andreabadan/STM32F103_Telemetry_V01/README.md

# STM32F103_Telemetry_V01
Board used to log data from karting training session and send them via bluetooth.  

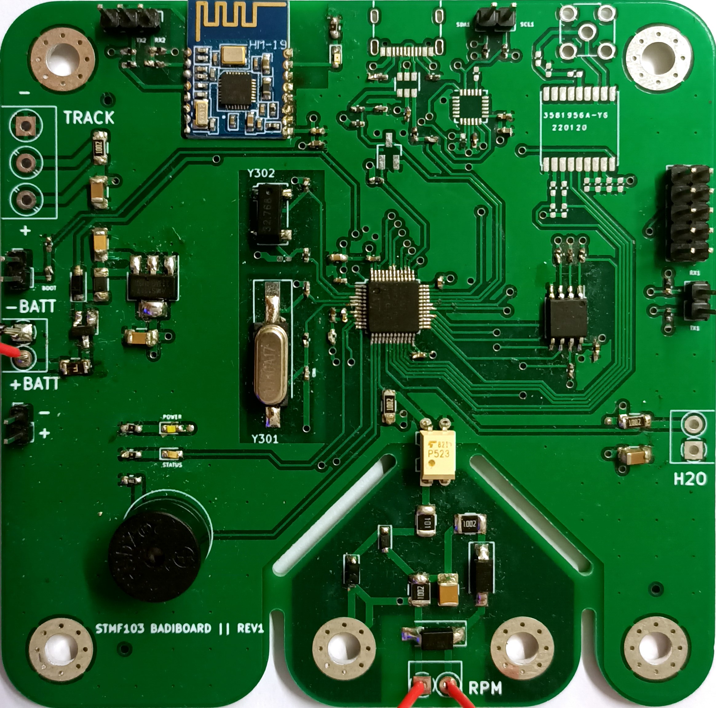
[picture p1: Board_STM32F103C8T6/Images/PCB.jpg]
