andreabadan/STM32F103_Telemetry_V01/Board_STM32F103C8T6/STM32F103C8T6/Assembly/Carrello_gen16_0939.xls

CARRELLO
Questa non è una fattura
16-gen-22 09:39:44
 | N. Mouser | N. produttore | Produttore | N. cliente | Descrizione | RoHS: | Ciclo di vita | Q.tà ordine | Prezzo (EUR) | Prezzo esteso: (EUR)
1 | 934-551403H02A | 55140-3H-02-A | Littelfuse |  | Sensori magnetici/a effetto Hall industriali MIN FLANGE MNT PROX SENS 3WIRE | A norma RoHS | NRND | 1 | 9,99 € | 9,99 €
2 | 934-55140AP02A | 55140-AP-02-A | Littelfuse |  | Sensori magnetici/a effetto Hall industriali 55140 AP02A HALL SENSOR | A norma RoHS |  | 1 | 13,58 € | 13,58 €
3 | 511-STM32F103C8T6 | STM32F103C8T6 | STMicroelectronics |  | Microcontrollori ARM - MCU 32BIT Cortex M3 64KB 20KB RAM 2X12 ADC | A norma RoHS |  | 1 | 6,13 € | 6,13 €
4 | 581-0402YD104K | 0402YD104KAT2A | Kyocera AVX |  | Condensatori in ceramica multistrato MLCC - SMD/SMT 16V 0.1uF X5R 0402 10% | A norma RoHS |  | 13 | 0,022 € | 0,29 €
5 | 581-0402YD105KAT4A | 0402YD105KAT4A | Kyocera AVX |  | Condensatori in ceramica multistrato MLCC - SMD/SMT 16V 1uF X5R 0402 10% AEC-Q200 | A norma RoHS |  | 1 | 0,333 € | 0,33 €
6 | 581-0402ZC103KAT2A | 0402ZC103KAT2A | Kyocera AVX |  | Condensatori in ceramica multistrato MLCC - SMD/SMT 10V 0.01uF X7R 0402 10% | A norma RoHS |  | 2 | 0,263 € | 0,53 €
7 | 581-1206VC104KAT2A | 1206VC104KAT2A | Kyocera AVX |  | Condensatori in ceramica multistrato MLCC - SMD/SMT 250V .1uF X7R 1206 10% Tol | A norma RoHS |  | 1 | 0,621 € | 0,62 €
8 | 581-1206DD106KAT2A | 1206DD106KAT2A | Kyocera AVX |  | Condensatori in ceramica multistrato MLCC - SMD/SMT 35V 10uF X5R 1206 10% | A norma RoHS |  | 3 | 0,613 € | 1,84 €
9 | 581-0603ZD475KAT2A | 0603ZD475KAT2A | Kyocera AVX |  | Condensatori in ceramica multistrato MLCC - SMD/SMT 10V 4.7uF X5R 0603 10% | A norma RoHS |  | 1 | 0,324 € | 0,32 €
10 | 581-0402ZA470JAT2A | 0402ZA470JAT2A | Kyocera AVX |  | Condensatori in ceramica multistrato MLCC - SMD/SMT 10V 47pF C0G 0402 5% | A norma RoHS |  | 2 | 0,28 € | 0,56 €
11 | 581-0402ZD106MAT2A | 0402ZD106MAT2A | Kyocera AVX |  | Condensatori in ceramica multistrato MLCC - SMD/SMT 10V 10uF X5R 0402 20% | A norma RoHS |  | 3 | 0,473 € | 1,42 €
12 | 581-0402YC222J4T2A | 0402YC222J4T2A | Kyocera AVX |  | Condensatori in ceramica multistrato MLCC - SMD/SMT 16V 2200pF X7R 0402 5% AEC-Q200 | A norma RoHS |  | 1 | 0,359 € | 0,36 €
13 | 581-1210VC224KAT2A | 1210VC224KAT2A | Kyocera AVX |  | Condensatori in ceramica multistrato MLCC - SMD/SMT 250V 0.22uF X7R 1210 10% | A norma RoHS | Nuovo prodotto | 1 | 0,656 € | 0,66 €
14 | 833-B5819W-TP | B5819W-TP | Micro Commercial Components (MCC) |  | Diodi e raddrizzatori Schottky 1A, 40V | A norma RoHS |  | 1 | 0,35 € | 0,35 €
15 | 710-150060GS75020 | 150060GS75020 | Wurth Elektronik |  | LED standard - SMD Mono Waterclear 670mcd 3.2V 140 | A norma RoHS |  | 1 | 0,315 € | 0,32 €
16 | 710-150060BS55040 | 150060BS55040 | Wurth Elektronik |  | LED standard - SMD WL-SMCD SMD Mono SMD 0603 Blue 465nm | A norma RoHS |  | 1 | 0,158 € | 0,16 €
17 | 710-150060RS75020 | 150060RS75020 | Wurth Elektronik |  | LED standard - SMD Mono Waterclear 80mcd 2V 140 | A norma RoHS |  | 1 | 0,315 € | 0,32 €
18 | 78-BZT52C5V1-E3-18 | BZT52C5V1-E3-18 | Vishay |  | Diodi Zener 5.1 Volt 0.5W 5% | A norma RoHS |  | 1 | 0,254 € | 0,25 €
19 | 576-1206L050YR | 1206L050YR | Littelfuse |  | Fusibili resettabili - PPTC 1206 PTC 6V 500MA | A norma RoHS |  | 1 | 0,411 € | 0,41 €
20 | 70-ILHB1206ER601V | ILHB1206ER601V | Vishay |  | Perline di ferrite 600ohms 25% | A norma RoHS |  | 1 | 0,166 € | 0,17 €
21 | 710-7447840139 | 7447840139 | Wurth Elektronik |  | Induttori fissi WE-MK 0402 39nH 200mA DCR=1.06ohm | A norma RoHS | Nuovo a Mouser | 1 | 0,088 € | 0,09 €
22 | 710-7447840210G | 7447840210G | Wurth Elektronik |  | Induttori fissi WE-MK DCRes= 1.6Ohms 0402 0.15A +/- 2% | A norma RoHS | Nuovo prodotto | 1 | 0,088 € | 0,09 €
23 | 726-BSS123NH6327 | BSS123N H6327 | Infineon |  | MOSFET N-Ch 100V 190mA SOT-23-3 | A norma RoHS |  | 1 | 0,368 € | 0,37 €
24 | 511-LD1117S33 | LD1117S33TR | STMicroelectronics |  | Regolatori di tensione LDO 3.3V 0.8A Positive | Conforme RoHS per esenzione |  | 1 | 0,525 € | 0,53 €
25 | 454-W25Q128JVSIQTR | W25Q128JVSIQ TR | Winbond |  | NOR Flash spiFlash, 3V, 128M-bit, 4Kb Uniform Sector | A norma RoHS |  | 1 | 1,74 € | 1,74 €
26 | 511-USBLC6-2SC6 | USBLC6-2SC6 | STMicroelectronics |  | Soppressori ESD/Diodi TVS ESD Protection Low Cap | A norma RoHS |  | 1 | 0,49 € | 0,49 €
27 | 581-04025U240FAT2A | 04025U240FAT2A | Kyocera AVX |  | Condensatori in ceramica multistrato MLCC - SMD/SMT 50V 24pF C0G 0402 1% | A norma RoHS |  | 2 | 0,315 € | 0,63 €
28 | 660-RN73H1ETP7870D25 | RN73H1ETTP7870D25 | KOA Speer |  | Resistori a pellicola sottile - SMD 787Ohm,0402,0.5%,25p pm,63mW,50V | A norma RoHS |  | 1 | 0,503 € | 0,50 €
29 | 581-04023U130FAT2A | 04023U130FAT2A | Kyocera AVX |  | Condensatori in ceramica multistrato MLCC - SMD/SMT 25V 13pF C0G 0402 1% | A norma RoHS |  | 2 | 0,333 € | 0,67 €
30 | 815-ABS25-32.7K-4-T | ABS25-32.768KHz-4-T | ABRACON |  | Cristalli CRYSTAL 32.7680KHZ 12.5PF SMD | Conforme RoHS per esenzione |  | 1 | 0,91 € | 0,91 €
31 | 660-RN73H1ETP3602D25 | RN73H1ETTP3602D25 | KOA Speer |  | Resistori a pellicola sottile - SMD 36kOhm,0402,0.5%,25p pm,63mW,50V | A norma RoHS |  | 1 | 0,503 € | 0,50 €
32 | 815-ABLS-8.0M-T | ABLS-8.000MHZ-B4-T | ABRACON |  | Cristalli 8.0 MHZ 18PF 80 OHM AUTO | A norma RoHS |  | 1 | 0,236 € | 0,24 €
33 | 78-SI2301CDS-T1-BE3 | SI2301CDS-T1-BE3 | Vishay |  | MOSFET P-CHANNEL 20-V (D-S) | A norma RoHS | Nuovo prodotto | 1 | 0,446 € | 0,45 €
34 | 78-SI2312BDS-T1-BE3 | SI2312BDS-T1-BE3 | Vishay |  | MOSFET N-CHANNEL 20-V (D-S) | A norma RoHS | Nuovo prodotto | 1 | 0,543 € | 0,54 €
35 | 241-1N4148WSR100001 | 1N4148WS_R1_00001 | Panjit |  | Diodi - Uso generico, alimentazione, commutazione /A2/TR/7"/HF/5K/SOD-323/SWI/SOD/USM-02A/USM02-QI08/PJ/// | A norma RoHS | Nuovo a Mouser | 1 | 0,123 € | 0,12 €
36 | 755-KTR03EZPJ152 | KTR03EZPJ152 | ROHM Semiconductor |  | Resistori a pellicola spessa - SMD 0603 1.5Kohm 5% High Voltage | Conforme RoHS per esenzione |  | 3 | 0,123 € | 0,37 €
37 | 652-CR0402FX-2201GLF | CR0402-FX-2201GLF | Bourns |  | Resistori a pellicola spessa - SMD 2.2K OHM 1% | Conforme RoHS per esenzione |  | 2 | 0,088 € | 0,18 €
38 | 652-CR0402-FX7870GLF | CR0402-FX-7870GLF | Bourns |  | Resistori a pellicola spessa - SMD 787OHM 1/16WATT 1% | Conforme RoHS per esenzione |  | 1 | 0,123 € | 0,12 €
39 | 71-CRCW0402J-36K-E3 | CRCW040236K0JNED | Vishay |  | Resistori a pellicola spessa - SMD 1/16watt 36Kohms 5% | Conforme RoHS per esenzione |  | 1 | 0,088 € | 0,09 €
40 | 71-CRCW04024K70FKEDC | CRCW04024K70FKEDC | Vishay |  | Resistori a pellicola spessa - SMD 1/16watt 4.7Kohms 1% Commercial Use | Conforme RoHS per esenzione |  | 1 | 0,088 € | 0,09 €
41 | 71-CRCW040210K0FKEDC | CRCW040210K0FKEDC | Vishay |  | Resistori a pellicola spessa - SMD 1/16watt 10Kohms 1% Commercial Use | Conforme RoHS per esenzione |  | 5 | 0,088 € | 0,44 €
42 | 652-CR0402FX-1501GLF | CR0402-FX-1501GLF | Bourns |  | Resistori a pellicola spessa - SMD 1.5K OHM 1% | Conforme RoHS per esenzione |  | 1 | 0,088 € | 0,09 €
43 | 652-CR0402FX-2202GLF | CR0402-FX-2202GLF | Bourns |  | Resistori a pellicola spessa - SMD 22K OHM 1% | Conforme RoHS per esenzione |  | 2 | 0,088 € | 0,18 €
44 | 652-CR0402FX-1001GLF | CR0402-FX-1001GLF | Bourns |  | Resistori a pellicola spessa - SMD 1.0K OHM 1% | Conforme RoHS per esenzione |  | 2 | 0,088 € | 0,18 €
45 | 652-CR0402-J/-000GLF | CR0402-J/-000GLF | Bourns |  | Resistori a pellicola spessa - SMD Zero Ohm 5% | Conforme RoHS per esenzione |  | 2 | 0,088 € | 0,18 €
46 | 652-CR0603-FX-103ELF | CR0603-FX-1003ELF | Bourns |  | Resistori a pellicola spessa - SMD 100K 1% 1/10 WATT | Conforme RoHS per esenzione |  | 1 | 0,088 € | 0,09 €
47 | 603-RC1210FR-0710KL | RC1210FR-0710KL | YAGEO |  | Resistori a pellicola spessa - SMD 10 kOhms 500 mW 1210 1% | Conforme RoHS per esenzione |  | 2 | 0,149 € | 0,30 €
48 | 652-CR1206FX-1002ELF | CR1206-FX-1002ELF | Bourns |  | Resistori a pellicola spessa - SMD 10K 1% | Conforme RoHS per esenzione |  | 3 | 0,088 € | 0,26 €
49 | 652-CR0402JW-104GLF | CR0402-JW-104GLF | Bourns |  | Resistori a pellicola spessa - SMD 100K OHM 5% | Conforme RoHS per esenzione |  | 8 | 0,088 € | 0,70 €
50 | 538-73391-0080 | 73391-0080 | Molex |  | Connettori RF/Connettori coassiali RA JACK PCB | Conforme RoHS per esenzione |  | 1 | 3,37 € | 3,37 €
51 | 640-USB4105-GF-A | USB4105-GF-A | Global Connector Technology (GCT) |  | Connettori USB USB Type C,2.0, Rec,SMT,TH Shell Stakes,G/F,RA,Top Mnt,T&R | A norma RoHS | Nuovo prodotto | 1 | 0,709 € | 0,71 €
52 | 621-S1B-F | S1B-13-F | Diodes Incorporated |  | Raddrizzatori 100V 1A | Conforme RoHS per esenzione |  | 2 | 0,236 € | 0,47 €
53 | 652-CR0402-JW-512GLF | CR0402-JW-512GLF | Bourns |  | Resistori a pellicola spessa - SMD 5.1KOHM 1/16WATT 5% | Conforme RoHS per esenzione |  | 2 | 0,088 € | 0,18 €
54 | 660-RK73B2ETTD101J | RK73B2ETTD101J | KOA Speer |  | Resistori a pellicola spessa - SMD 1/2watts 100ohms 5% | Conforme RoHS per esenzione |  | 1 | 0,161 € | 0,16 €
Inviando l'ordine si accettano queste termini e condizioni. (https://www.mouser.it/saleterms) |  |  |  |  |  |  |  |  | Merce: | 54,64 €
I prezzi riflettono quelli validi alla data e all'ora mostrate. |  |  |  |  |  |  |  |  | Spese di spedizione: | 0,00 €
 |  |  |  |  |  |  |  |  | Spedizione ordini arretrati: | 0,00 €
