andreabadan/STM32F103_Telemetry_V01/Board_STM32F103C8T6/Case/FrontPanel.stl

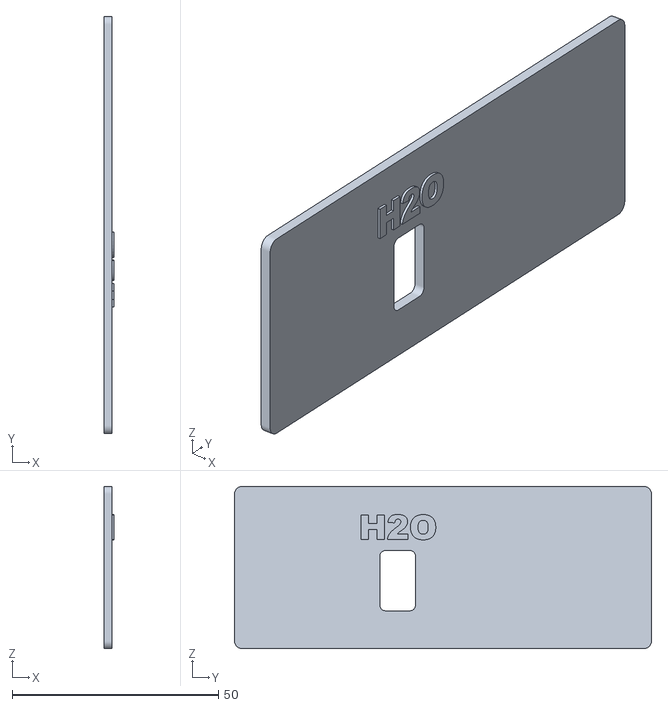
[picture p2: CAD file, 2022-06-16]
Board_STM32F103C8T6/Case/FrontPanel.stl
2.50 x 101.2 x 39.4
