andreabadan/STM32F103_Telemetry_V01/Board_STM32F103C8T6/Case/Top.stl

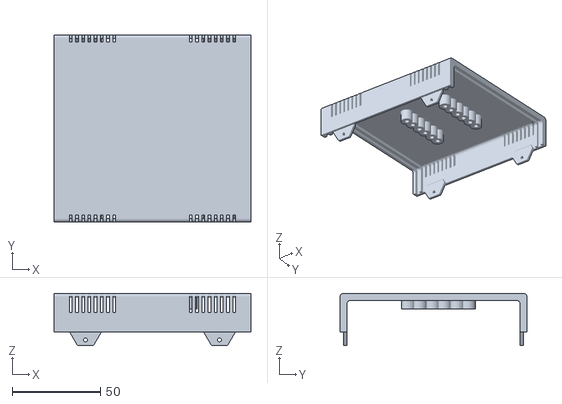
[picture p4: CAD file, 2022-06-16]
Board_STM32F103C8T6/Case/Top.stl
111.6 x 106.0 x 29.6
