andreabadan/STM32F103_Telemetry_V01/Board_STM32F103C8T6/Case/Battery.stl

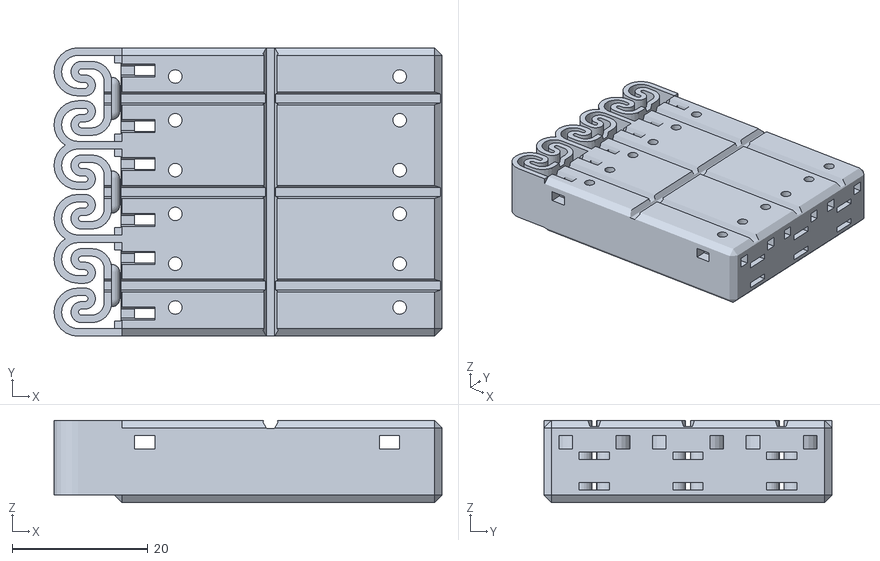
[picture p5: CAD file, 2022-06-16]
Board_STM32F103C8T6/Case/Battery.stl
57.2 x 42.5 x 12.1
