andreabadan/STM32F103_Telemetry_V01/Board_STM32F103C8T6/Simulation/RPM_probe_simulation.asc

C1: cap; 0.1µ; V=16 Irms=3.85 Rser=0.0464862 Lser=0
D1: diode; 1N4007
D2: diode; 1N4007
D3: diode; 1N4148
D5: zener; 1N751
R1: res; 4.75K; tol=1 pwr=0.1
R2: res; 10K; tol=1 pwr=0.1
R3: res; 100; tol=1 pwr=0.1
R4: res; 20K; tol=1 pwr=0.1
U1: PC817A
V1: voltage; PULSE(0 5 0 0.01m 0.01m 1m 10m); Rser=0
V2: voltage; 3.3; Rser=0
Named nets: 0
.tran 40m
