andreabadan/STM32F103_Telemetry_V01/Board_STM32F103C8T6/STM32F103C8T6/STM32F103C8T6.kicad_pcb

## KiCad design Board_STM32F103C8T6/STM32F103C8T6/STM32F103C8T6.kicad_pcb (2022-05-08)

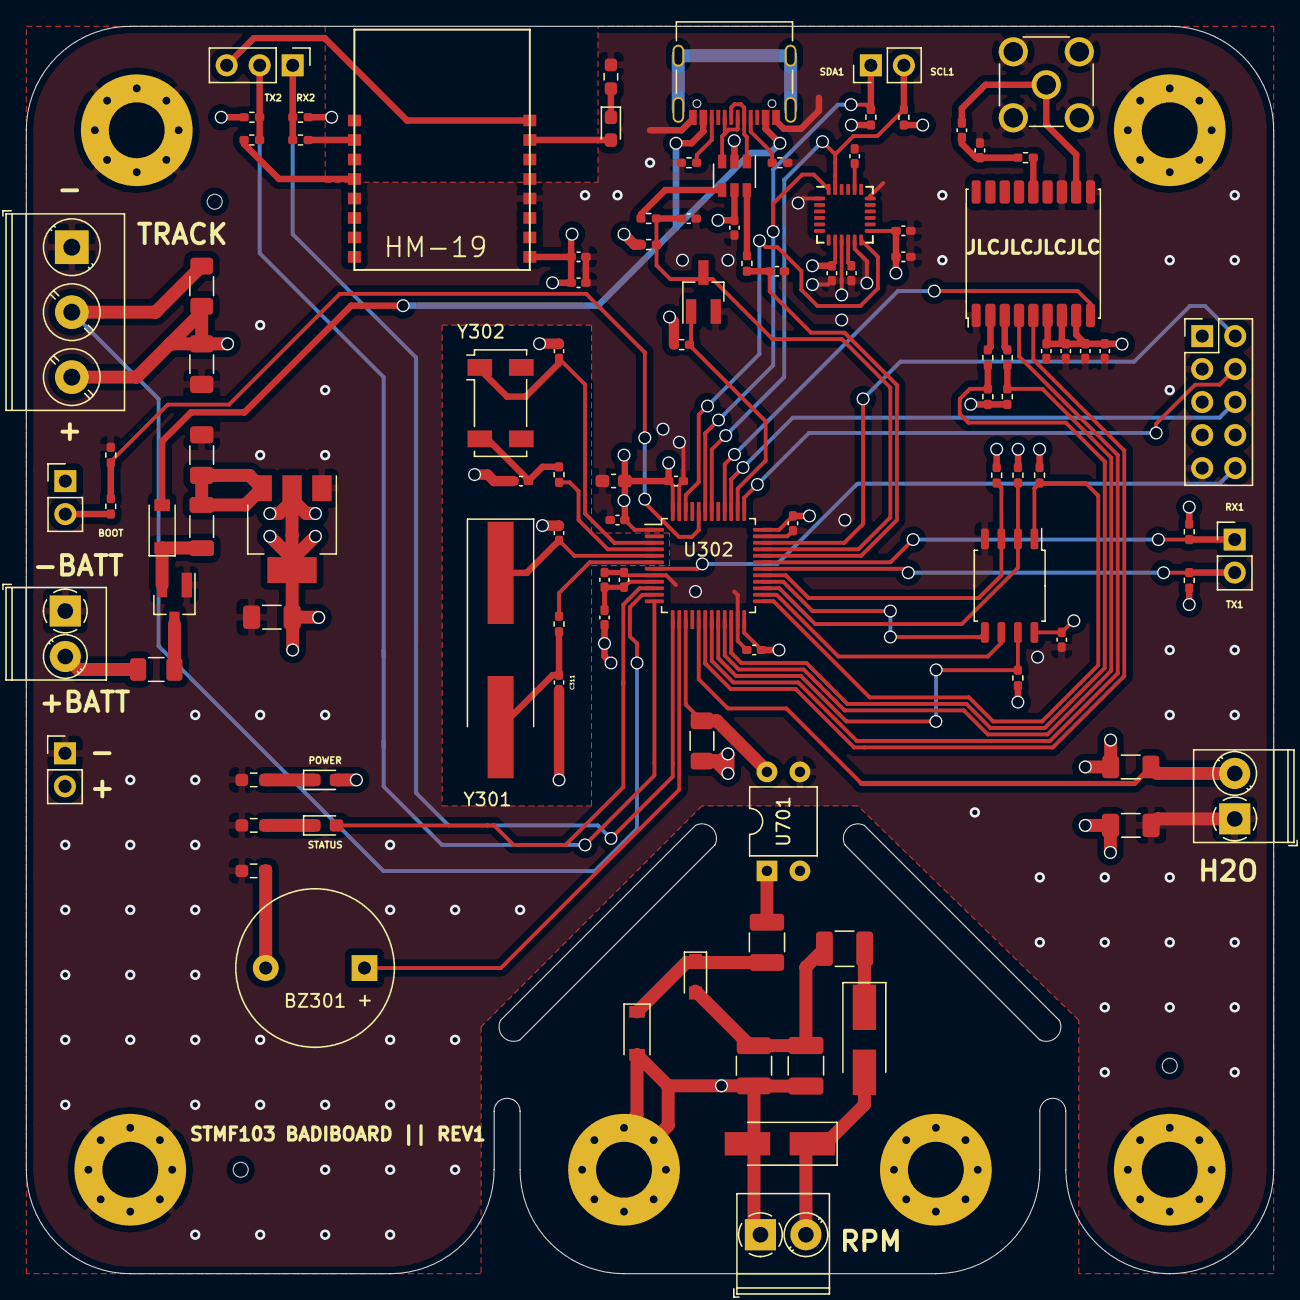
[picture p15: board STM32F103C8T6.kicad_pcb from above]

Board: 4 copper layers, 96.0 x 96.0 mm, 115 parts (0 on the bottom side), 73 nets.

Parts:
BZ301: Buzzer; Buzzer_12x9.5RM7.6
C201: 0.1uF; C_1206_3216Metric_Pad1.33x1.80mm_HandSolder
C202, C701, C703: 10uF; C_1206_3216Metric_Pad1.33x1.80mm_HandSolder
C301: 4.7uF; C_0603_1608Metric_Pad1.08x0.95mm_HandSolder
C302, C303, C304, C305, C308, C401, C502, C503, C504, C602, C802, C803, C804: 0.1uF; C_0402_1005Metric_Pad0.74x0.62mm_HandSolder
C306: 1uF; C_0402_1005Metric_Pad0.74x0.62mm_HandSolder
C307, C805: 0.01uF; C_0402_1005Metric_Pad0.74x0.62mm_HandSolder
C309, C311: 24pF; C_0402_1005Metric_Pad0.74x0.62mm_HandSolder
C310, C312: 13pF; C_0402_1005Metric_Pad0.74x0.62mm_HandSolder
C402, C403: 47pF; C_0402_1005Metric_Pad0.74x0.62mm_HandSolder
C501, C601, C801: 10uF; C_0402_1005Metric_Pad0.74x0.62mm_HandSolder
C505: 2200pF; C_0402_1005Metric_Pad0.74x0.62mm_HandSolder
C702: 0.1uF; C_1210_3225Metric_Pad1.33x2.70mm_HandSolder
D201: B5819W; D_SOD-123
D202: GREEN; LED_0603_1608Metric_Pad1.05x0.95mm_HandSolder
D301: BLUE; LED_0603_1608Metric_Pad1.05x0.95mm_HandSolder
D601: RED; LED_0603_1608Metric_Pad1.05x0.95mm_HandSolder
D701, D702: 1N4007F; D_SMA_Handsoldering
D703: 1N4148WS; D_SOD-323_HandSoldering
D704: 5v1; D_SOD-123
F201: 500mA; Fuse_1206_3216Metric
FB201: 600 @ 600 MHz; L_1206_3216Metric_Pad1.22x1.90mm_HandSolder
H301, H302, H303, H304, H305, H306: MountingHole_Pad; MountingHole_4.3mm_M4_Pad_Via
H307, H308, H309: MountingHole; JLCPCB-Tooling-Hole
J301: BOOT; PinHeader_1x02_P2.54mm_Vertical
J401: BATTERY; TerminalBlock_Phoenix_PT-1,5-2-3.5-H_1x02_P3.50mm_Horizontal
J402: I2C; PinHeader_1x02_P2.54mm_Vertical
J403: H2O; TerminalBlock_Phoenix_PT-1,5-2-3.5-H_1x02_P3.50mm_Horizontal
J404: USB_C_Receptacle_USB2.0; USB_C_Receptacle_Palconn_UTC16-G
J405: SWD; PinHeader_2x05_P2.54mm_Vertical
J406: USART1; PinHeader_1x02_P2.54mm_Vertical
J407: CIRCUIT_SENSOR; TerminalBlock_Phoenix_PT-1,5-3-5.0-H_1x03_P5.00mm_Horizontal
J408: BLUETOOTH; PinHeader_1x03_P2.54mm_Vertical
J409: RPM; TerminalBlock_Phoenix_PT-1,5-2-3.5-H_1x02_P3.50mm_Horizontal
J410: POWER; PinHeader_1x02_P2.54mm_Vertical
J801: Conn_Coaxial; SMA_Molex_73251-2200_Horizontal
L301: 39nH; L_0402_1005Metric_Pad0.77x0.64mm_HandSolder
L801: 100nH; L_0402_1005Metric_Pad0.77x0.64mm_HandSolder
Q201: SI2301CDS-T1-BE3; SOT-23_Handsoldering
Q301: SI2312BDS-T1-BE3; SOT-23_Handsoldering
R201, R311, R603: 1.5kΩ; R_0603_1608Metric_Pad0.98x0.95mm_HandSolder
R301, R302: 2.2kΩ; R_0402_1005Metric_Pad0.72x0.64mm_HandSolder
R303, R304, R306, R308, R309, R310, R313, R314: 100kΩ; R_0402_1005Metric_Pad0.72x0.64mm_HandSolder
R305: 787Ω; R_0402_1005Metric_Pad0.72x0.64mm_HandSolder
R307: 36kΩ; R_0402_1005Metric_Pad0.72x0.64mm_HandSolder
R312: 100kΩ; R_0603_1608Metric_Pad0.98x0.95mm_HandSolder
R315, R316, R318, R320, R803: 10kΩ; R_0402_1005Metric_Pad0.72x0.64mm_HandSolder
R317: 4.7kΩ; R_0402_1005Metric_Pad0.72x0.64mm_HandSolder
R319: 1.5kΩ; R_0402_1005Metric_Pad0.72x0.64mm_HandSolder
R401, R402: 22kΩ; R_0402_1005Metric_Pad0.72x0.64mm_HandSolder
R403, R404: 5.1kΩ; R_0402_1005Metric_Pad0.72x0.64mm_HandSolder
R601, R602: 1kΩ; R_0402_1005Metric_Pad0.72x0.64mm_HandSolder
R701, R702, R706: 10kΩ; R_1206_3216Metric_Pad1.30x1.75mm_HandSolder
R703, R704: 10kΩ; R_1210_3225Metric_Pad1.30x2.65mm_HandSolder
R705: 100Ω; R_1210_3225Metric_Pad1.30x2.65mm_HandSolder
R801, R802: 0kΩ; R_0402_1005Metric_Pad0.72x0.64mm_HandSolder
U201: LD1117S33TR; SOT-223-3_TabPin2
U301: W25Q128JVS; SOIC-8_5.23x5.23mm_P1.27mm
U302: STM32F103C8T6; LQFP-48_7x7mm_P0.5mm
U401: USBLC6-2SC6; SOT-23-6
U501: MPU-6050; InvenSense_QFN-24_4x4mm_P0.5mm
U601: HM-19; HM-11_Module
U701: TLP627; DIP-4_W7.62mm
U801: MAX-M8Q; ublox_MAX
Y301: 8MHz; Crystal_SMD_HC49-SD_HandSoldering
Y302: 32.768KHz; Crystal_SMD_Abracon_ABS25-4Pin_8.0x3.8mm

Connections:
12C1_SDA: J402.1, R301.1, U302.43, U501.24
!HOLD_FLASH: R315.1, U301.7, U302.20
!WP_FLASH: R316.1, U301.3, U302.29
+3.3VA: C306.1, C307.1, L301.2, U302.9
+3V3: C202.1, C301.1, C302.1, C303.1, C304.1, C305.1, C308.1, C401.1, C501.1, C502.1, C503.1, C601.1, C602.1, C701.1, C703.1, C801.1, C802.1, C803.1, C804.1, D202.2, J301.1, J405.1, J407.3, J410.2, L301.1, R301.2, R302.2, R303.2, R304.2, R306.2, R308.2, R309.2, R310.2, R313.2, R314.2, R315.2, R316.2, R319.2, R320.1, R701.1, R702.1, R706.1, U201.2, U301.8, U302.1, U302.24, U302.36, U302.48, U401.5, U501.8, U501.13, U601.9, U801.6, U801.7, U801.8
+5V: D201.2, J404.A4, J404.A9, J404.B4, J404.B9
+BATT: F201.2, J401.2
BLUETOOTH_RESET: J408.3, U601.16
BOOT0: R317.1, R318.2, U302.44
BUZZER_STATUS: BZ301.1, U302.14
COIL_RPM: D701.1, D702.2, J409.2
GND: C201.2, C202.2, C301.2, C302.2, C303.2, C304.2, C305.2, C306.2, C307.2, C308.2, C309.2, C310.2, C311.2, C312.2, C401.2, C402.2, C403.2, C501.2, C502.2, C503.2, C504.2, C505.2, C601.2, C602.2, C701.2, C703.2, C801.2, C802.2, C803.2, C804.2, C805.2, H301.1, H302.1, H303.1, H304.1, J401.1, J403.1, J404.A1, J404.A12, J404.B1, J404.B12, J405.3, J405.5, J405.9, J407.1, J410.1, J801.2, Q201.1, Q301.2, R201.2, R311.1, R312.1, R318.1, R403.1, R404.1, R603.1, U201.1, U301.4, U302.8, U302.23, U302.35, U302.47, U401.2, U501.1, U501.9, U501.11, U501.18, U601.12, U701.3, U801.1, U801.10, U801.12
GND1: C702.2, D701.2, D704.2, H305.1, H306.1, J409.1, R704.2, U701.2
GPS_NRST: U302.40, U801.9
GPS_ONOFF: U302.18, U801.5
GPS_PPS: U302.19, U801.4
H2O_NTC+: J403.2, R702.2, U302.17
HSE_IN: C309.1, U302.5, Y301.1
HSE_OUT: R305.2, U302.6
I2C1_SCL: J402.2, R302.1, U302.42, U501.23
IMU_INTERRUPT: U302.46, U501.12
LED_STATUS: D301.2, U302.10
LSE_IN: C310.1, U302.3, Y302.1
LSE_OUT: R307.2, U302.4
NRST: J405.10, U302.7
unnamed: BZ301.2, R312.2
unnamed: C201.1, FB201.1, U201.3
unnamed: C311.1, R305.1, Y301.2
unnamed: C312.1, R307.1, Y302.2
unnamed: C504.1, U501.10
unnamed: C505.1, U501.20
unnamed: C702.1, D703.2, R703.1, R704.1
unnamed: C805.1, L801.1, R803.1
unnamed: D201.1, FB201.2, Q201.2
unnamed: D202.1, R201.1
unnamed: D301.1, R311.2
unnamed: D601.1, R603.2
unnamed: D601.2, U601.15
unnamed: D702.1, R703.2
unnamed: D703.1, D704.1, R705.2
unnamed: F201.1, Q201.3
unnamed: J301.2, R317.2
unnamed: J404.A5, R404.2
unnamed: J404.B5, R403.2
unnamed: J801.1, L801.2, U801.11
unnamed: R401.1, U401.6
unnamed: R402.2, U401.4
unnamed: R601.2, U601.2
unnamed: R602.2, U601.4
unnamed: R705.1, U701.1
unnamed: R801.2, U801.2
unnamed: R802.2, U801.3
unnamed: R803.2, U801.14
RPM_SENSOR: R706.2, U302.15, U701.4
SPI2_MISO: R313.1, U301.2, U302.27
SPI2_MOSI: U301.5, U302.28
SPI2_NSS_FLASH: R314.1, U301.1, U302.25
SPI2_SCK: U301.6, U302.26
SWCLK: J405.4, U302.37
SWDIO: J405.2, U302.34
SWO: J405.6, U302.39
TRACK_SENSOR: J407.2, R701.2, U302.11
USART1_RX: J406.1, R303.1, U302.31
USART1_TX: J406.2, R304.1, U302.30
USART2_RX: J408.1, R306.1, R601.1, U302.13
USART2_TX: J408.2, R308.1, R602.1, U302.12
USART3_RX: R310.1, R801.1, U302.22
USART3_TX: R309.1, R802.1, U302.21
USB_CONN_D+: J404.A6, J404.B6, U401.3
USB_CONN_D-: J404.A7, J404.B7, U401.1
USB_D+: C403.1, Q301.3, R319.1, R402.1, U302.33
USB_D-: C402.1, R401.2, U302.32
USB_EN: Q301.1, R320.2, U302.38
