andreabadan/STM32F103_Telemetry_V01/BadiApp_STM32F103CBT6/Core/Src/main.c

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
/* Includes ------------------------------------------------------------------*/
#include "main.h"
#include "usb_device.h"

/* USER CODE BEGIN Includes */
#include "usbd_cdc_if.h"

#include "BootLoaderMng.h"

#include "MemoryMng.h"

#include "BluetoothMng.h"

#include "RPM_Counter.h"
#include "Lap_Timer.h"
#include "Temperature_Sensor.h"
/* USER CODE END Includes */

ADC_HandleTypeDef hadc1;
DMA_HandleTypeDef hdma_adc1;

I2C_HandleTypeDef hi2c1;

RTC_HandleTypeDef hrtc;

SPI_HandleTypeDef hspi2;
DMA_HandleTypeDef hdma_spi2_tx;
DMA_HandleTypeDef hdma_spi2_rx;

UART_HandleTypeDef huart1;
UART_HandleTypeDef huart2;
UART_HandleTypeDef huart3;
DMA_HandleTypeDef hdma_usart2_tx;
DMA_HandleTypeDef hdma_usart2_rx;

void SystemClock_Config(void);
static void MX_GPIO_Init(void);
static void MX_DMA_Init(void);
static void MX_ADC1_Init(void);
static void MX_I2C1_Init(void);
static void MX_RTC_Init(void);
static void MX_SPI2_Init(void);
static void MX_USART1_UART_Init(void);
static void MX_USART2_UART_Init(void);
static void MX_USART3_UART_Init(void);
/**
  * @brief  The application entry point.
  * @retval int
  */
int main(void)
{
  /* MCU Configuration--------------------------------------------------------*/

  /* Reset of all peripherals, Initializes the Flash interface and the Systick. */
  HAL_Init();

  /* Configure the system clock */
  SystemClock_Config();

  /* Initialize all configured peripherals */
  MX_GPIO_Init();
  MX_DMA_Init();
  MX_ADC1_Init();
  MX_I2C1_Init();
  MX_RTC_Init();
  MX_SPI2_Init();
  MX_USART1_UART_Init();
  MX_USART2_UART_Init();
  MX_USART3_UART_Init();
  MX_USB_DEVICE_Init();
  /* USER CODE BEGIN 2 */
  // Calibrate The ADC On Power-Up For Better Accuracy
  HAL_ADCEx_Calibration_Start(&hadc1);
  //Initialization of "micros" counter
  CoreDebug->DEMCR |= CoreDebug_DEMCR_TRCENA_Msk;
  DWT->CTRL |= DWT_CTRL_CYCCNTENA_Msk;

  /*************/
  /*Init Funct**/
  /*************/
  //Initialization of "BootLoader"
  initBootLoaderMode();
  //Initialization of "NOR memory"
  initMemory(&hspi2);
  //Initialization of "Bluetooth"
  initBluetoothCommunication(&huart2);
  //Initialization of "RPM counter"
  initCounterRPM();
  //Initialization of "Track counter"
  initCounterLap();
  //Initialization of "Read temperature"
  initReadTemperature();

  /*************/
  /*****USB*****/
  /*************/
  char txtBufUSB[BUFFER_USB_LENGTH];
  uint16_t sizeBuffUSB = 0;

#ifdef DebugRPM
  uint8_t RPMdelay = 60; //From 5 to 60
  uint8_t RPMincreasing = 1; //From 0 to 1
#endif
  /* USER CODE END 2 */

  /* Infinite loop */
  /* USER CODE BEGIN WHILE */
  while (1)
  {
    /* USER CODE END WHILE */

    /* USER CODE BEGIN 3 */
	  uint32_t currentMillis = HAL_GetTick();
	  uint8_t logUpdated = 0;
	  //Write log data
	  if(currentMillis-previousMillis_LogUpdate > DELAY_LOG_UPDATE_TIME) {
		  calculateRPM();
		  //LOG
		  if(engineStatus == TurnedOn) {
			  //Session started
			  updateLog( "%u" SESSION, 111, 0); //4 Characters
		  }
		  if(engineStatus != Off) {
			  //RPM value
			  updateLog( "%u" RPM_SYMBOL, RPM_Value, 0); //6 Characters
			  if(engineStatus == TurnedOff) {
				  //Session finished
				  updateLog( "%u" SESSION, 111, 1); //4 Characters
			  }
		  }
		  //Update counter
		  previousMillis_LogUpdate = currentMillis;
		  logUpdated = 1;
	  }
	  //RPM update
	  if(currentMillis-previousMillisRPM_Display > CALCULATE_RPM_DELTA_TIME){
		  if(!logUpdated) {
			  calculateRPM();
		  }
		  //USB
		  sizeBuffUSB += sprintf(txtBufUSB, "RPM_Value: %u ", RPM_Value);
		  //BT
		  appendBTData( "%u" RPM_SYMBOL, RPM_Value); //6 Characters
		  //Update counter
		  previousMillisRPM_Display = currentMillis;
	  }
	  //Time update
	  if(currentMillis > previousMillisLap_Display && currentMillis-previousMillisLap_Display > CALCULATE_LAP_DELTA_TIME && !LapUpdateDisplay){
		  //USB
		  sizeBuffUSB += sprintf(txtBufUSB + sizeBuffUSB, "Lap value: %lu ", currentMillis-previousMillisLap);
		  //BT
		  appendBTData("%lu" LAP_SYMBOL, currentMillis-previousMillisLap); //11 Characters
		  //Update counter
		  previousMillisLap_Display = currentMillis;
	  }
	  //Track update
	  if(LapUpdateDisplay){
		  //USB
		  sizeBuffUSB += sprintf(txtBufUSB + sizeBuffUSB, "!--! Lap value: %lu !--! ", Lap_Value);
		  //BT
		  appendBTData(LAPFINISHED_SYMBOL "%lu" LAP_SYMBOL, Lap_Value); //12 Characters
		  //LOG
		  updateLog(LAPFINISHED_SYMBOL "%lu" LAP_SYMBOL, Lap_Value, 0); //12 Characters
		  //Update counter
		  previousMillisLap_Display = currentMillis + DELAY_DISPLAY_LAP_TIME;
		  LapUpdateDisplay = 0;
	  }
	  //Temperature sensor
	  if(currentMillis-previousMillisTemperature_Display > DELAY_DISPLAY_TEMPERATUIRE_SENSOR_TIME){
		  //Calculate temperature
		  if(calculateTemperature() || bluetoothStatus == Connecting){
			  //USB
			  sizeBuffUSB += sprintf(txtBufUSB + sizeBuffUSB, "Temp: %u ", TemperatureValue);
			  //BT
			  switch(TemperatureAlarmUpdateDisplay){
				  case ProbeOk:
				  case ProbeInit:
					  //BT
					  appendBTData("%u" TEMP_SYMBOL, TemperatureValue); //6 Characters
					  //LOG
					  updateLog("%u" TEMP_SYMBOL, TemperatureValue, 0); //6 Characters
					  break;
				  case HighTemperature:
					  //BT
					  appendBTData(HIGHTEMP_SYMBOL "%u" TEMP_SYMBOL, TemperatureValue); //7 Characters
					  //LOG
					  updateLog(HIGHTEMP_SYMBOL "%u" TEMP_SYMBOL, TemperatureValue, 0); //7 Characters
					  break;
				  case ProbeNotConnected:
				  case ProbeErrorReading:
					  //BT
					  appendBTData(PROBEBROKE_SYMBOL "%u" TEMP_SYMBOL, 0); //3 Characters
					  //LOG
					  updateLog(PROBEBROKE_SYMBOL "%u" TEMP_SYMBOL, 0, 0); //3 Characters
					  break;
			  }
		  }
		  //Update counter
		  previousMillisTemperature_Display = currentMillis;
	  }
	  //Read temperature value
	  if(currentMillis-previousMillisTemperature_Read > CALCULATE_TEMPERATUIRE_SENSOR_TIME){
		  HAL_ADC_Start_DMA(&hadc1, &ActualRead, 1);
		  //Update counter
		  previousMillisTemperature_Read = currentMillis;
	  }

#ifdef debugBT
	  sizeBuffUSB = sizeBuffBT;
	  for(int i=0; i<sizeBuffBT; i++)
		  txtBufUSB[i] = txtBufBT[i];
#endif
	  //Print via USB all informations
	  if(sizeBuffUSB > 0){
		  sizeBuffUSB += sprintf(txtBufUSB + sizeBuffUSB, "\r\n");
		  memset(txtBufUSB + sizeBuffUSB, 0, BUFFER_USB_LENGTH - sizeBuffUSB); //Deleate value into unused buffer
		  CDC_Transmit_FS((uint8_t *)txtBufUSB, sizeBuffUSB);
		  sizeBuffUSB   = 0;
	  }
	  //Print via BT all informations
	  writeBTData(&huart2);
	  //Led status
	  HAL_GPIO_TogglePin (Led_status_GPIO_Port, Led_status_Pin);
#ifdef DebugRPM
	  if(RPMincreasing){
	  //RPM increase = delay decrease
		  if(RPMdelay <= 5)
			  RPMincreasing = 0;
		  else
			  RPMdelay = RPMdelay - 1;
	  } else {
	  //RPM decrease = delay increase
		  if(RPMdelay >= 60)
			  RPMincreasing = 1;
		  else
			  RPMdelay = RPMdelay + 1;
	  }

	  for(int i = 0; i < CALCULATE_RPM_DELTA_TIME; i=i+RPMdelay){
		  deltaTimeInterruptRPM(DWT->CYCCNT / (SystemCoreClock / 1000000U));
		  HAL_Delay(RPMdelay-1);
	  }
#else
	  HAL_Delay(25);
#endif
  }
  /* USER CODE END 3 */
}

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
/* USER CODE BEGIN 4 */
// EXTI Line9 External Interrupt ISR Handler CallBackFun
void HAL_GPIO_EXTI_Callback(uint16_t GPIO_Pin)
{
    if(GPIO_Pin == Track_Sensor_Pin) // If The INT Source Is EXTI Line1 (Track_Sensor)
	{
    	deltaTimeInterruptLap(HAL_GetTick());
	}
    if(GPIO_Pin == RPM_Sensor_Pin) // If The INT Source Is EXTI Line5 (RPM_Sensor)
    {
    	deltaTimeInterruptRPM(DWT->CYCCNT / (SystemCoreClock / 1000000U));
    }
}
// ADC callback (temperature sensor)
void HAL_ADC_ConvCpltCallback(ADC_HandleTypeDef* hadc)
{
    // Conversion complete & DMA transfer complete as well
	averageRead();
}
// DMA USART Callback
void HAL_UARTEx_RxEventCallback(UART_HandleTypeDef *huart, uint16_t Size)
{
	switch(readBTData(huart, Size)){
		case LoadNewApp:
			jumpToBootLoader(FlashModeBT);
			break;
		default: break;
	}

}
// DMA SPI Callback
void HAL_SPI_TxRxCpltCallback(SPI_HandleTypeDef * hspi)
{
    if(hspi->Instance == SPI2){
    	MemoryMNG_Callback();
    }
}
/* USER CODE END 4 */
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
