andreabadan/STM32F103_Telemetry_V01/BadiApp_STM32F103CBT6/BadiApp_STM32F103CBT6.ioc

Mcu.UserName=STM32F103CBTx
PA0-WKUP.GPIO_Label=Led status
PA0-WKUP.Signal=GPIO_Output
PA1.GPIO_Label=Track_Sensor
PA1.Signal=GPXTI1
PA10.Signal=USART1_RX
PA11.Signal=USB_DM
PA12.Signal=USB_DP
PA13.Signal=SYS_JTMS-SWDIO
PA14.Signal=SYS_JTCK-SWCLK
PA2.Signal=USART2_TX
PA3.Signal=USART2_RX
PA4.GPIO_Label=Buzzer
PA4.Signal=GPIO_Output
PA5.GPIO_Label=RPM_Sensor
PA5.Signal=GPXTI5
PA7.GPIO_Label=H2O_NTC+
PA7.Signal=ADCx_IN7
PA8.GPIO_Label=WP_Flash
PA8.Signal=GPIO_Output
PA9.Signal=USART1_TX
PB0.GPIO_Label=GPS_ONOFF
PB0.Signal=GPIO_Output
PB1.GPIO_Label=GPS_PPS
PB1.Signal=GPIO_Input
PB10.Signal=USART3_TX
PB11.Signal=USART3_RX
PB12.GPIO_Label=SPI2_NSS
PB12.Signal=GPIO_Output
PB13.Signal=SPI2_SCK
PB14.Signal=SPI2_MISO
PB15.Signal=SPI2_MOSI
PB2.GPIO_Label=HOLD_Flash
PB2.Signal=GPIO_Output
PB3.Signal=SYS_JTDO-TRACESWO
PB4.GPIO_Label=GPS_NRST
PB4.Signal=GPIO_Output
PB6.Signal=I2C1_SCL
PB7.Signal=I2C1_SDA
PB9.GPIO_Label=IMU_Interrupt
PB9.Signal=GPIO_Input
PC14-OSC32_IN.Signal=RCC_OSC32_IN
PC15-OSC32_OUT.Signal=RCC_OSC32_OUT
PD0-OSC_IN.Signal=RCC_OSC_IN
PD1-OSC_OUT.Signal=RCC_OSC_OUT
