andreabadan/STM32F103_Telemetry_V01/BadiApp_STM32F103CBT6/Core/Inc/main.h

#define Led_status_Pin GPIO_PIN_0
#define Led_status_GPIO_Port GPIOA
#define Track_Sensor_Pin GPIO_PIN_1
#define Track_Sensor_GPIO_Port GPIOA
#define Track_Sensor_EXTI_IRQn EXTI1_IRQn
#define Buzzer_Pin GPIO_PIN_4
#define Buzzer_GPIO_Port GPIOA
#define RPM_Sensor_Pin GPIO_PIN_5
#define RPM_Sensor_GPIO_Port GPIOA
#define RPM_Sensor_EXTI_IRQn EXTI9_5_IRQn
#define H2O_NTC__Pin GPIO_PIN_7
#define H2O_NTC__GPIO_Port GPIOA
#define GPS_ONOFF_Pin GPIO_PIN_0
#define GPS_ONOFF_GPIO_Port GPIOB
#define GPS_PPS_Pin GPIO_PIN_1
#define GPS_PPS_GPIO_Port GPIOB
#define HOLD_Flash_Pin GPIO_PIN_2
#define HOLD_Flash_GPIO_Port GPIOB
#define SPI2_NSS_Pin GPIO_PIN_12
#define SPI2_NSS_GPIO_Port GPIOB
#define WP_Flash_Pin GPIO_PIN_8
#define WP_Flash_GPIO_Port GPIOA
#define GPS_NRST_Pin GPIO_PIN_4
#define GPS_NRST_GPIO_Port GPIOB
#define IMU_Interrupt_Pin GPIO_PIN_9
#define IMU_Interrupt_GPIO_Port GPIOB
#define VERISON "0.0.1B"
#define BUFFER_USB_LENGTH 100
