andreabadan/STM32F103_Telemetry_V01/BadiApp_STM32F103CBT6/Core/Src/BluetoothMng.c

/*
 * BluetoothMng.c
 *
 *  Created on: October 17, 2021
 *      Author: BadiBoard
 */

#include "BluetoothMng.h"

//Variable declaration
BluetoothStatus bluetoothStatus;

//RX
uint8_t rxBuffer[RXSIZE];
//TX
char txBuffer[BUFFER_BT_LENGTH];
uint16_t sizeTxBuffer;
char _writeFWVersion;

//Initialization of all variables
void initBluetoothCommunication(UART_HandleTypeDef *huart){
	//Initialization of DMA
	HAL_UARTEx_ReceiveToIdle_DMA (huart, rxBuffer, RXSIZE);
	bluetoothStatus = Connected;
	sizeTxBuffer = 0;

	_writeFWVersion = 0;
	//TODO: Increase boudrate and set name
}

//Append new data
void appendBTData(char *options, uint32_t value){
	if(bluetoothStatus==Connected){
		// TODO: Check array out of bound
		sizeTxBuffer += sprintf(txBuffer + sizeTxBuffer, options, value);
	} else {
		sizeTxBuffer  = 0;
		memset(txBuffer, 0, BUFFER_BT_LENGTH);
	}
}

//Print all pending data
HAL_StatusTypeDef writeBTData(UART_HandleTypeDef *huart) {
	HAL_StatusTypeDef trasmission = HAL_OK;
	//Add FW version to packet
	if(_writeFWVersion == 1){
		sizeTxBuffer += sprintf(txBuffer + sizeTxBuffer, VERISON W_FIRMWARE_VERSION); //UP to 10 Characters
		_writeFWVersion = 0;
	}
	if(sizeTxBuffer > 0 && (bluetoothStatus==Connecting || bluetoothStatus==Connected)){
		memset(txBuffer + sizeTxBuffer, 0, BUFFER_BT_LENGTH - sizeTxBuffer); //Deleate value into unused buffer
		trasmission = HAL_UART_Transmit_DMA(huart, (uint8_t*)txBuffer, sizeTxBuffer);
		if(trasmission == HAL_OK){
			sizeTxBuffer = 0;
		}
	}
	if(bluetoothStatus==Connecting){
		bluetoothStatus = Connected;
	}
	return(trasmission);
}

//Read the incoming data
BluetoothAction readBTData(UART_HandleTypeDef *huart, uint16_t Size) {
	if(huart->Instance==USART2) {
		//Jump to Bootloader
		if(Size == 4 &&
		   (char)rxBuffer[0] == BOOTLOADER_WRITE[0] &&
		   (char)rxBuffer[1] == BOOTLOADER_WRITE[1] &&
		   (char)rxBuffer[2] == BOOTLOADER_WRITE[2] &&
		   (char)rxBuffer[3] == BOOTLOADER_WRITE[3]) {
			HAL_UARTEx_ReceiveToIdle_DMA(huart, rxBuffer, RXSIZE);
			return(LoadNewApp);
		}
		//Get FW version
		if(Size == 3 &&
		   (char)rxBuffer[0] == R_FIRMWARE_VERSION[0] &&
		   (char)rxBuffer[1] == R_FIRMWARE_VERSION[1] &&
		   (char)rxBuffer[2] == R_FIRMWARE_VERSION[2]){
			HAL_UARTEx_ReceiveToIdle_DMA(huart, rxBuffer, RXSIZE);
			_writeFWVersion = 1;
			return(None);
		}
		//Stop communication
		if(Size == 9 && //Position 7 and 8 are /r and /n
		   (char)rxBuffer[0] == AT_NOT_CONNECTED[0] &&
		   (char)rxBuffer[1] == AT_NOT_CONNECTED[1] &&
		   (char)rxBuffer[2] == AT_NOT_CONNECTED[2] &&
		   (char)rxBuffer[3] == AT_NOT_CONNECTED[3] &&
		   (char)rxBuffer[4] == AT_NOT_CONNECTED[4] &&
		   (char)rxBuffer[5] == AT_NOT_CONNECTED[5] &&
		   (char)rxBuffer[6] == AT_NOT_CONNECTED[6]) {
			bluetoothStatus = Lost;
			HAL_UARTEx_ReceiveToIdle_DMA(huart, rxBuffer, RXSIZE);
			return(None);
		}
		//Start communication
		//WARNING: "AT_CONNECTED" must be at the and of searching procedure
		if(Size == 9 && //Position 7 and 8 are /r and /n
		   (char)rxBuffer[0] == AT_CONNECTED[0] &&
		   (char)rxBuffer[1] == AT_CONNECTED[1] &&
		   (char)rxBuffer[2] == AT_CONNECTED[2] &&
		   (char)rxBuffer[3] == AT_CONNECTED[3] &&
		   (char)rxBuffer[4] == AT_CONNECTED[4] &&
		   (char)rxBuffer[5] == AT_CONNECTED[5] &&
		   (char)rxBuffer[6] == AT_CONNECTED[6]) {
			bluetoothStatus = Connecting;
			_writeFWVersion = 1;
		}
		HAL_UARTEx_ReceiveToIdle_DMA(huart, rxBuffer, RXSIZE);
		return(None);
	}
	return(None);
}
