andreabadan/STM32F103_Telemetry_V01/BadiApp_STM32F103CBT6/Core/Inc/BluetoothMng.h

/*
 * BluetoothMng.h
 *
 *  Created on: October 17, 2021
 *      Author: BadiBoard
 */
 
#ifndef BLUETOOTH_MNG_H_
#define BLUETOOTH_MNG_H_

#define RPM_SYMBOL          "R"
#define LAP_SYMBOL          "L"
#define LAPFINISHED_SYMBOL  "F"
#define TEMP_SYMBOL         "T"
#define PROBEBROKE_SYMBOL   "B"
#define HIGHTEMP_SYMBOL     "H"
#define W_FIRMWARE_VERSION  "V"
#define SESSION				"S"

#define RXSIZE              20
#define BUFFER_BT_LENGTH    100

#define BOOTLOADER_WRITE    "BOOT"

#define R_FIRMWARE_VERSION  "FWV"

#define AT_CONNECTED        "OK+CONN"
#define AT_NOT_CONNECTED    "OK+LOST"

typedef enum
{
    Lost,
	Connecting,
	Connected
} BluetoothStatus;

typedef enum
{
    None,
	LoadNewApp
} BluetoothAction;

#include "main.h"
#include <string.h>

extern BluetoothStatus bluetoothStatus;

//RX
extern uint8_t rxBuffer[RXSIZE];
//TX
extern char txBuffer[BUFFER_BT_LENGTH];
extern uint16_t sizeTxBuffer;
extern char _writeFWVersion;

//Initialization of all variables
void initBluetoothCommunication(UART_HandleTypeDef *huart);

//Append new data
void appendBTData(char *options, uint32_t value);

//Print all pending data
HAL_StatusTypeDef writeBTData(UART_HandleTypeDef *huart);

//Read the incoming data
BluetoothAction readBTData(UART_HandleTypeDef *huart, uint16_t Size);

#endif /* BLUETOOTH_MNG_H_ */
