andreabadan/STM32F103_Telemetry_V01/(commit log)

2021-09-26 Bootloader
    Fixed issue with RAM management for bootloader function.
    Now ram address 0x20000000 to 0x200000010 are not initialized for BootLoader porpuse
    [bootloader.c, bootloader.h, main.c]
2021-10-21 Fixed bootloader comunication with USB and UART
    [bootloader.c, bootloader.h, main.c]
2021-11-07 H2O temperature probe error (work in progress)
    [BluetoothMng.h, Temperature_Sensor.c, Temperature_Sensor.h, main.c]
2021-12-12 Fixed temperature reading
2021-12-20 Filter (#2)
    * Added Kalman Filter to temperature probe
    * Initializate TemperatureAlarmThreeshold variable
    * Improved filter calculation
    * Improved filter params
    * Added filter to RPM value calculation
    * Added IIR Filter
    * Changed value of initial filter
2021-12-21 Fix receipt of messages
    [BluetoothMng.c]
2021-12-21 Added possibility to understand if reboot is requested from BT or USB
    [BluetoothMng.c, BootLoaderMng.h, main.c]
2021-12-29 Added schematic of board
    [BLUETOOTH.sch, Connectors.sch, GPS.sch, IMU.sch, MCU.sch, PROBES.sch, Power.sch, STM32F103C8T6.kicad_pcb]
2021-12-30 Updated board design
    work in progress
    [BLUETOOTH.sch, GPS.sch, MCU.sch, PROBES.sch, Power.sch, STM32F103C8T6.kicad_pcb]
2022-01-02 Improved PCB layout
    [Connectors.sch, MCU.sch, STM32F103C8T6.kicad_pcb]
2022-01-03 added files to product pcb
    [Connectors.sch, MCU.sch, PROBES.sch, Power.sch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]
2022-01-03 updated layout
    [STM32F103C8T6.kicad_pcb]
2022-01-08 Changed Crystals
    [BLUETOOTH.sch, Connectors.sch, GPS.sch, IMU.sch, MCU.sch, PROBES.sch, Power.sch, STM32F103C8T6.kicad_pcb]
2022-01-12 Change part number
    [BLUETOOTH.sch, Connectors.sch, GPS.sch, MCU.sch, PROBES.sch, Power.sch, STM32F103C8T6.kicad_pcb]
2022-01-16 Added descriptions
    [Carrello_gen16_0939.xls, Connectors.sch, MCU.sch, PROBES.sch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]
2022-01-19 Added b mask layer
    [STM32F103C8T6-B_Cu.gbr, STM32F103C8T6-B_Mask.gbr, STM32F103C8T6-B_Paste.gbr, STM32F103C8T6-B_SilkS.gbr, STM32F103C8T6-Edge_Cuts.gbr, STM32F103C8T6-F_Cu.gbr, STM32F103C8T6-F_Mask.gbr, STM32F103C8T6-F_Paste.gbr]
2022-05-08 Updated version from 5.1.9 to 6.0.5 (#7)
    [BLUETOOTH.kicad_sch, Connectors.kicad_sch, GPS.kicad_sch, IMU.kicad_sch, MCU.kicad_sch, PROBES.kicad_sch, Power.kicad_sch, STM32F103C8T6.kicad_pcb]
2022-05-13 Added 3d case model
    [BPanl.stl, Bottom.stl, Case.scad, FPanl.stl, Top.stl]
2022-05-14 Fixed 3d case model
    [BPanl.stl, BackPanel.stl, Bottom.stl, Case.scad, FPanl.stl, FrontPanel.stl, STM32F103C8T6.FCStd, Top.stl]
2022-05-21 Added battery to case
    [Battery.stl, Bottom.stl, Case.scad, Top.stl]
2022-06-03 Changed MCU from STM32F103C8T6 to STM32F103CBT6 (#9)
2022-06-16 Modified case
    Added screws
    [BackPanel.stl, Battery.stl, Bottom.stl, FrontPanel.stl, Top.stl]
2022-07-12 Fixed bluetooth update procedure
    [bootloader.c, bootloader.h, main.c]
2022-07-20 Fix size to erase
    [bootloader.h]
2022-07-20 Fix reset currentMicrosRPMtimer (every minute)
    [RPM_Counter.c]
2022-08-16 Fixed issue #11 (#12)
    [bootloader.c, bootloader.h]
2022-09-16 Fixed RPM signal simulation
    [main.c]
2023-01-26 Added schematic of board on PDF file
