andreabadan/STM32F103_Telemetry_V01/(notices)

Notices in the files:
BadiApp_STM32F103CBT6/Core/Inc/main.h:
Copyright (c) 2022 STMicroelectronics.
All rights reserved.
This software is licensed under terms that can be found in the LICENSE file
BadiApp_STM32F103CBT6/Core/Src/main.c:
© Copyright (c) 2021 STMicroelectronics.
This software component is licensed by ST under Ultimate Liberty license
